drewsdesign/rclights/eagle/rclights.brd

## EAGLE design eagle/rclights.brd (2013-08-04)

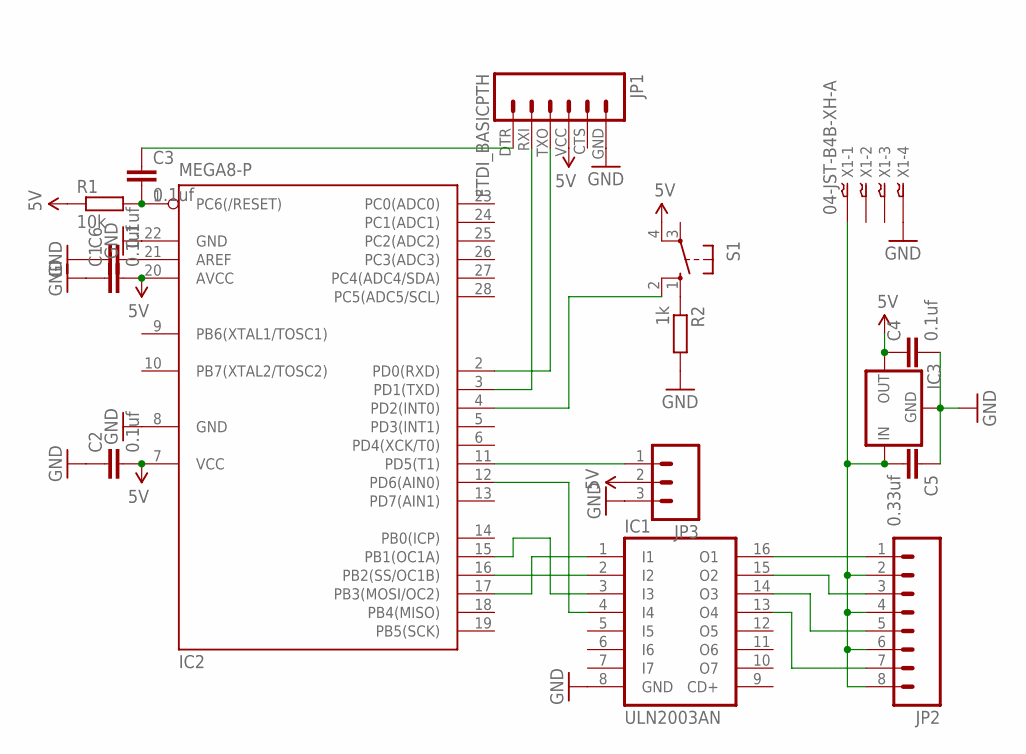
[picture p1: schematic rclights.sch]

Parts:
C1, C2, C3, C4, C6: 0.1uf; C025-025X050
C5: 0.33uf; C025-025X050
IC1: ULN2003AN; DIL16
IC2: MEGA8-P; DIL28-3
IC3: V_REG_78XX-TO-220; TO-220-ALT
JP1: FTDI_BASICPTH; FTDI_BASIC
JP2: M081X08; 1X08
JP3: M03PTH; 1X03
R1: 10k; 0207/10
R2: 1k; 0207/10
S1: 10-XX; B3F-10XX
X1: 04-JST-B4B-XH-A; B4B-XH

Connections:
5V: C1.2, C2.2, C4.1, IC2.7 (VCC), IC2.20 (AVCC), IC3.OUT, JP1.VCC (4), JP3.2, R1.1, S1.4 (P1)
GND: C1.1, C2.1, C4.2, C5.1, C6.1, IC1.8 (GND), IC2.8 (GND), IC2.22 (GND), IC3.GND, JP1.GND (6), JP3.3, R2.2, X1.P$4
unnamed: IC1.3 (I3), IC2.15 (PB1(OC1A))
unnamed: IC1.2 (I2), IC2.16 (PB2(SS/OC1B))
unnamed: R2.1, S1.1 (S)
unnamed: IC1.4 (I4), IC2.12 (PD6(AIN0))
unnamed: C5.2, IC3.IN, JP2.2, JP2.4, JP2.6, JP2.8, X1.P$1
unnamed: IC2.4 (PD2(INT0)), S1.2 (S1)
unnamed: C3.1, JP1.DTR (1)
unnamed: IC2.2 (PD0(RXD)), JP1.TXO (3)
unnamed: C3.2, IC2.1 (PC6(/RESET)), R1.2
unnamed: IC2.3 (PD1(TXD)), JP1.RXI (2)
unnamed: IC1.1 (I1), IC2.17 (PB3(MOSI/OC2))
unnamed: C6.2, IC2.21 (AREF)
unnamed: IC1.16 (O1), JP2.1
unnamed: IC1.15 (O2), JP2.3
unnamed: IC1.14 (O3), JP2.5
unnamed: IC1.13 (O4), JP2.7
RECEIVER: IC2.11 (PD5(T1)), JP3.1

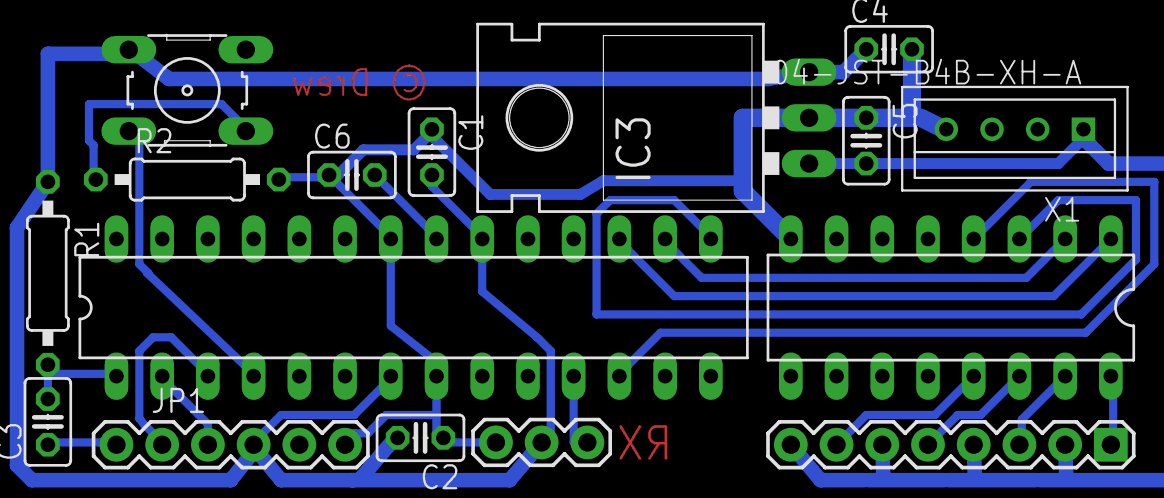
[picture p2: board rclights.brd from above]

Board: 2 copper layers, 16 parts (0 on the bottom side), 19 nets.
