drewsdesign/rclights/(notices)

Notices in the files:
eagle/rclights.brd:
© Drew
parts and their libraries:
SparkFun-Connectors: Licensing: CC v3.0 Share-Alike You are welcome to use this library for commercial purposes.
